vahid-anari/dotmatrix/docs/images/app-clock.png

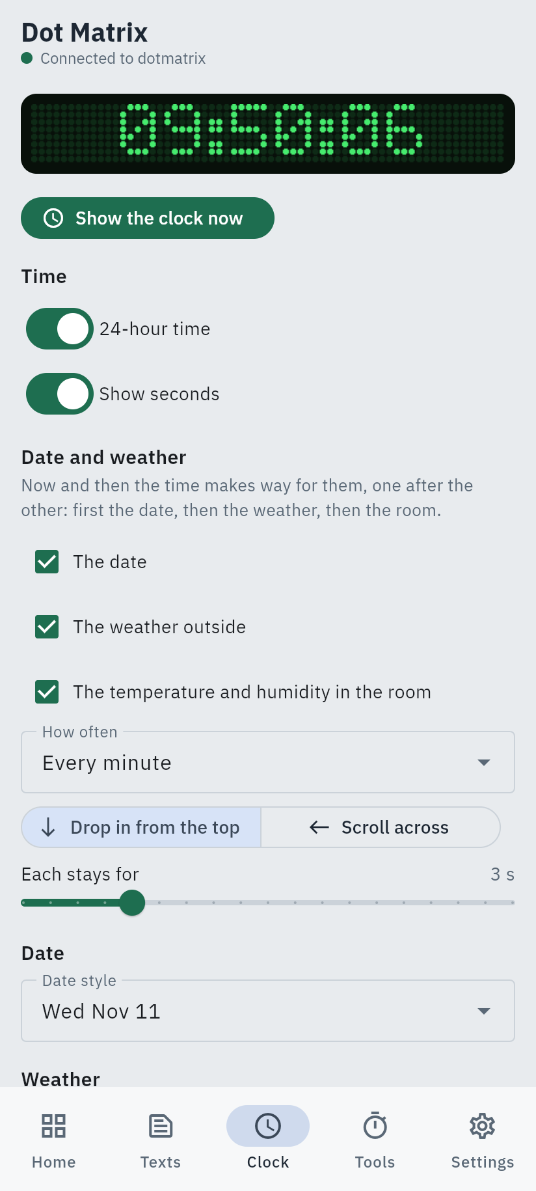
docs/images/app-clock.png
