vahid-anari/dotmatrix/docs/images/app-editor.png

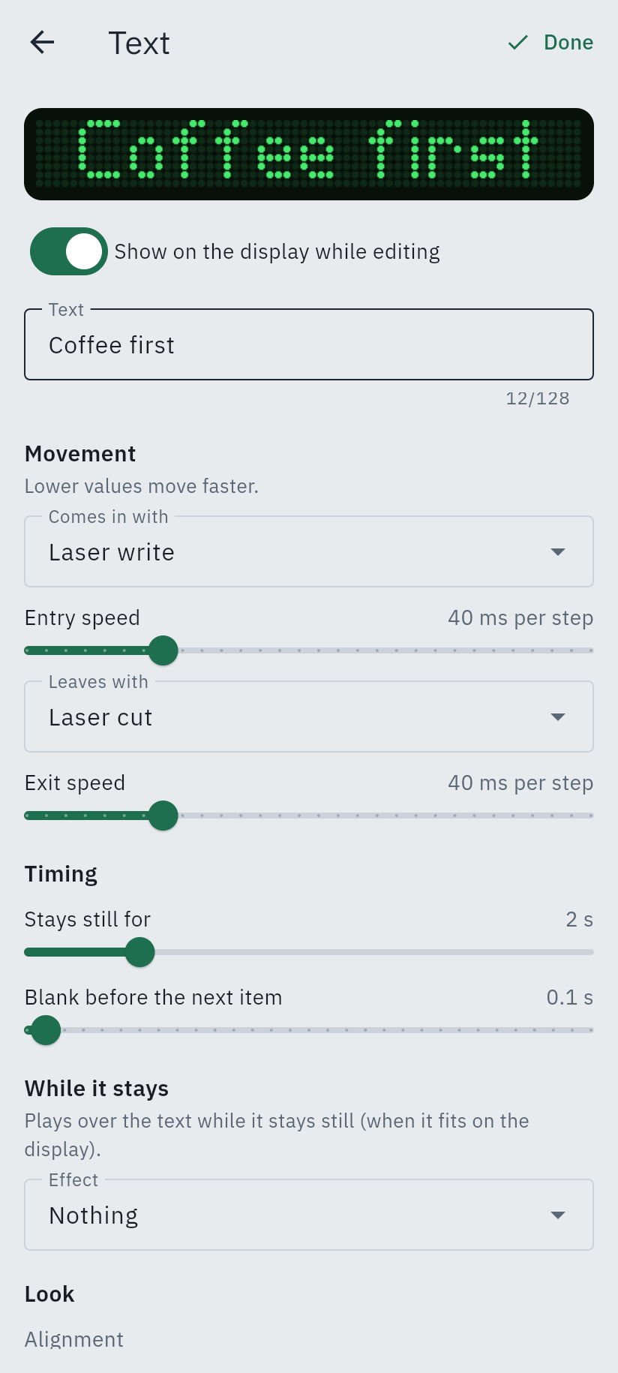
docs/images/app-editor.png
