vahid-anari/dotmatrix/docs/images/app-home.png

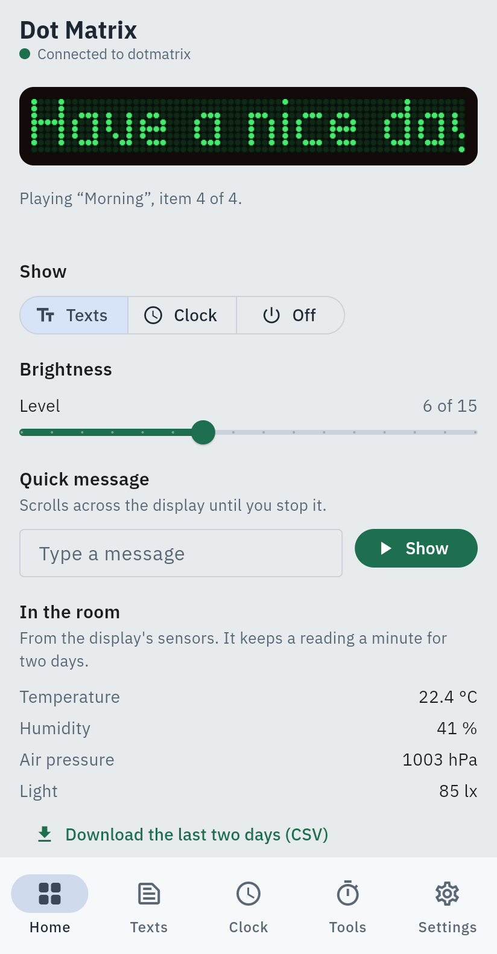
docs/images/app-home.png
