vahid-anari/dotmatrix/docs/images/app-texts.png

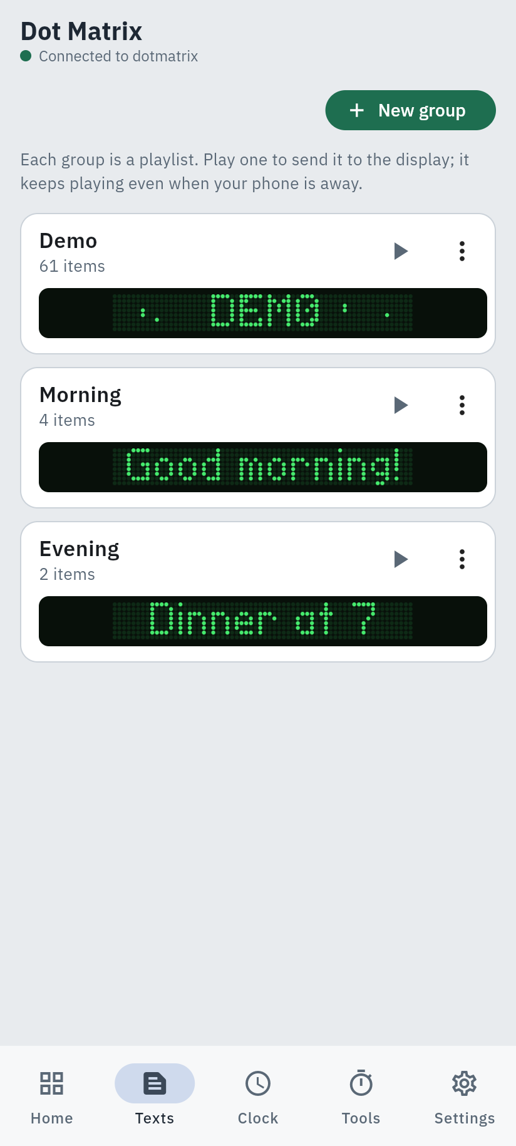
docs/images/app-texts.png
