vahid-anari/dotmatrix/docs/images/app-tools.png

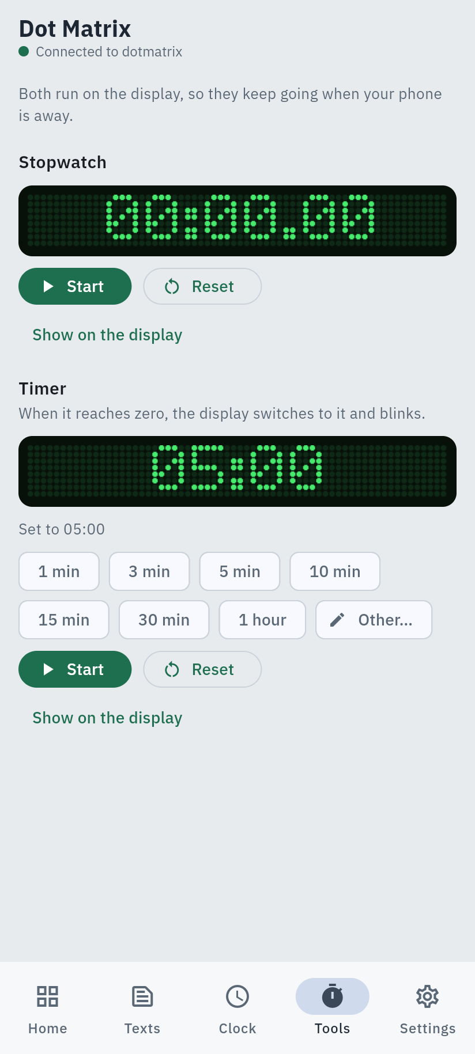
docs/images/app-tools.png
