vahid-anari/dotmatrix/case/stl/assembled-preview.stl

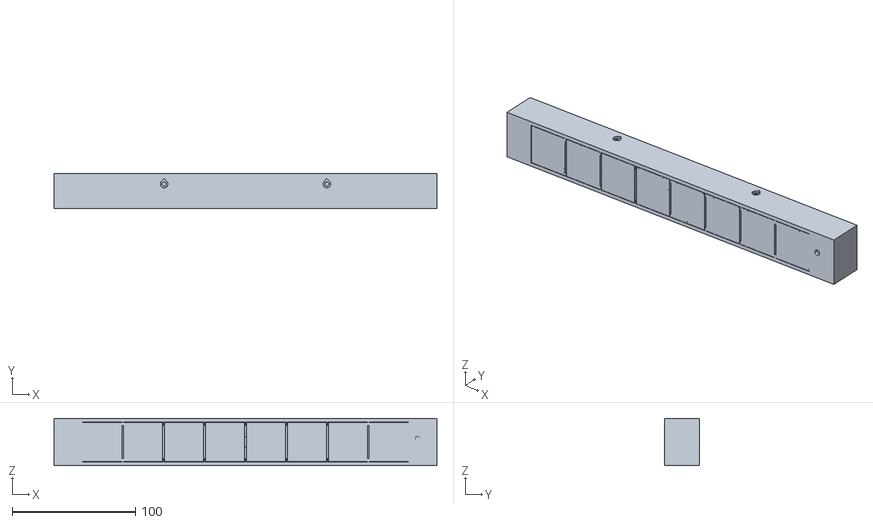
[picture p12: CAD file, 2026-11-11]
case/stl/assembled-preview.stl
310.6 x 28.1 x 38.4
