vahid-anari/dotmatrix/case/stl/foot.stl

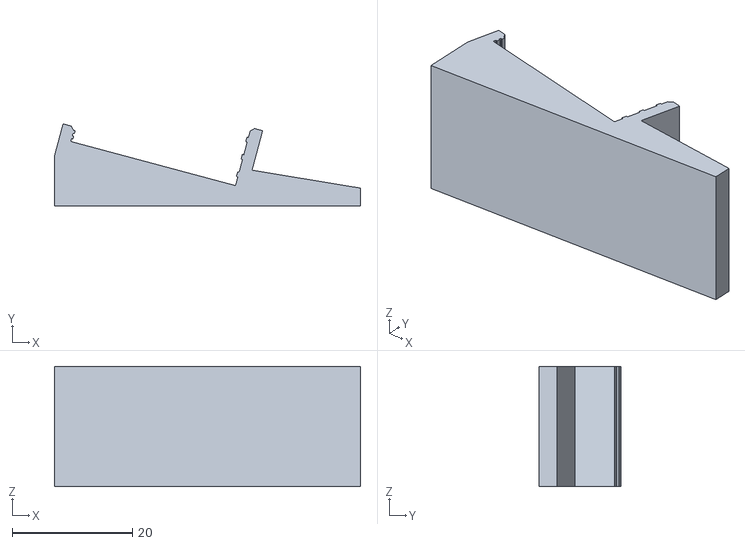
[picture p13: CAD file, 2026-11-12]
case/stl/foot.stl
51.0 x 13.7 x 20.0
