vahid-anari/dotmatrix/case/stl/test_frame.stl

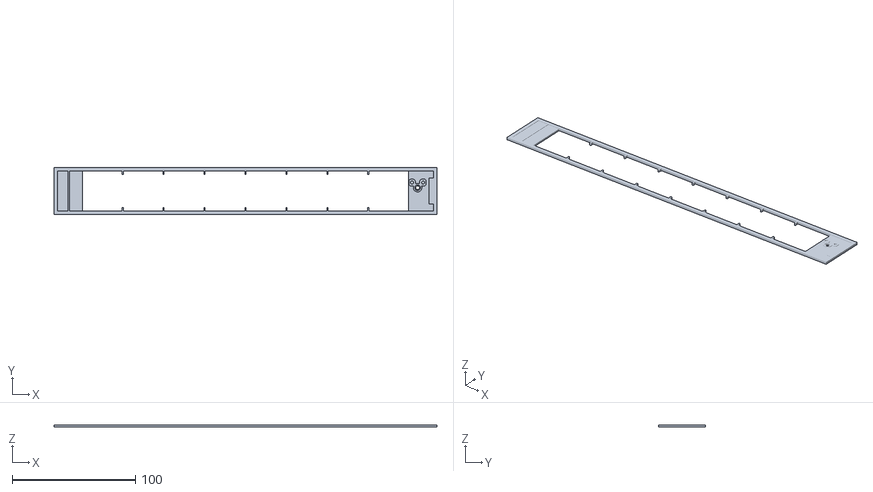
[picture p14: CAD file, 2026-11-11]
case/stl/test_frame.stl
310.6 x 38.4 x 2.00
