vahid-anari/dotmatrix/case/stl/cover.stl

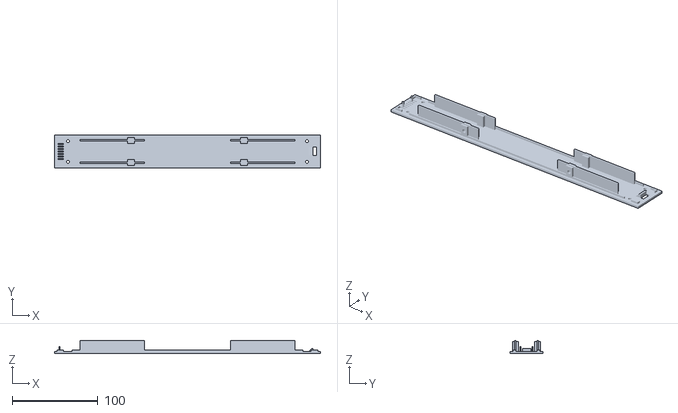
[picture p16: CAD file, 2026-11-11]
case/stl/cover.stl
310.6 x 38.4 x 15.4
