vahid-anari/dotmatrix/case/stl/case.stl

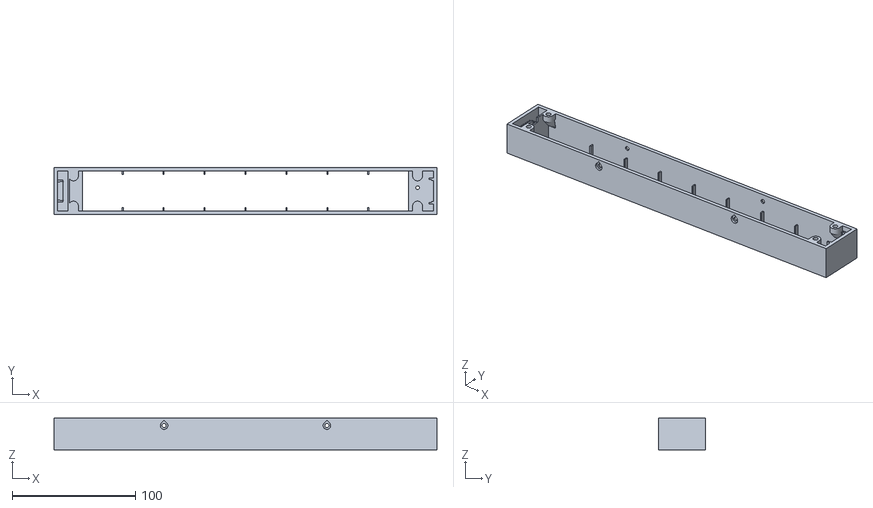
[picture p17: CAD file, 2026-11-11]
case/stl/case.stl
310.6 x 38.4 x 25.7
