vahid-anari/dotmatrix/case/stl/test_cover_l.stl

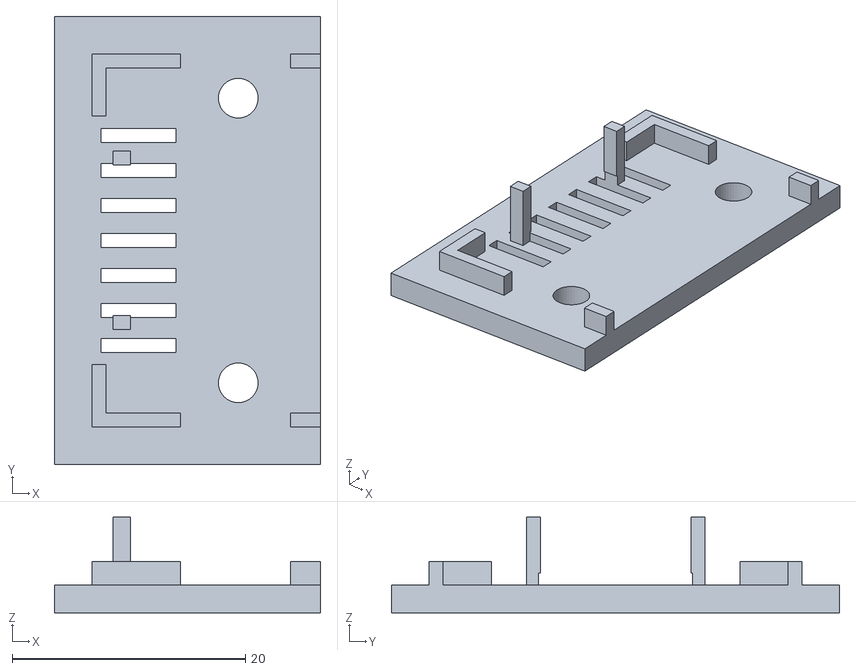
[picture p18: CAD file, 2026-11-11]
case/stl/test_cover_l.stl
22.8 x 38.4 x 8.19
