vahid-anari/dotmatrix/case/stl/test_end_l.stl

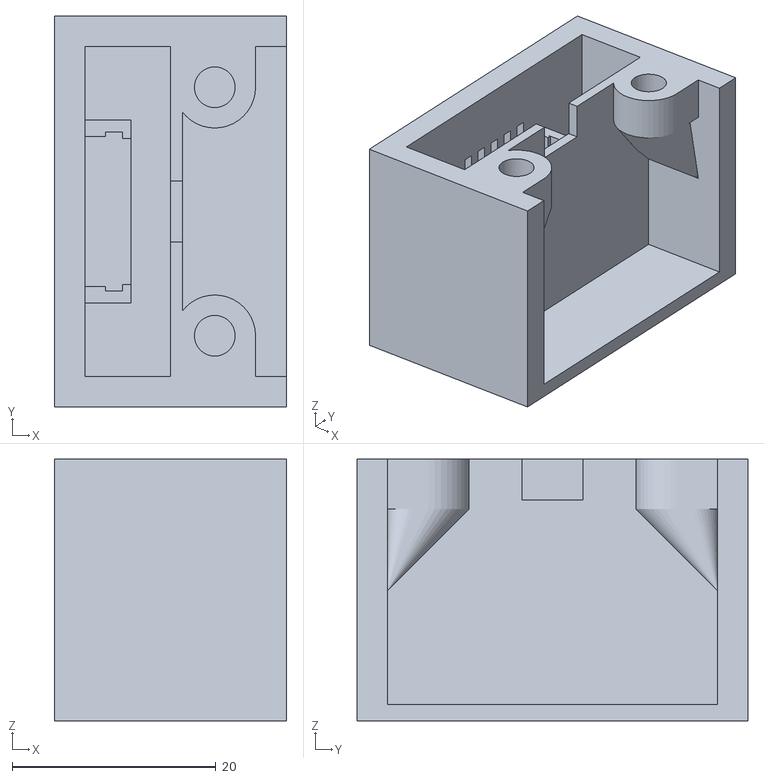
[picture p19: CAD file, 2026-11-11]
case/stl/test_end_l.stl
22.8 x 38.4 x 25.7
