vahid-anari/dotmatrix/case/stl/test_cover.stl

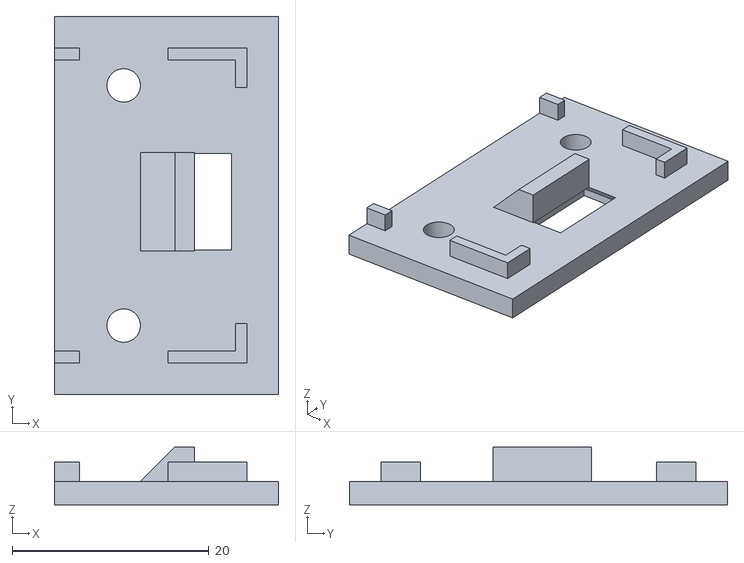
[picture p20: CAD file, 2026-11-11]
case/stl/test_cover.stl
22.8 x 38.4 x 5.89
