vahid-anari/dotmatrix/CHANGELOG.md

# Changelog

Released with tags `vX.Y.Z`; each release carries the signed APK and the firmware,
which the app offers as updates. The version is the app's; the firmware takes the
same number when it changes too.

## 0.8.5 — 2026-11-14

- The Wi-Fi radio stays awake again: with the capacitor, 0.8.3 (awake) had no
  drops, while 0.8.4 (dozing) dropped for a second every few minutes.

## 0.8.4 — 2026-11-14

- Found the cause of the Wi-Fi drops: the display's current spikes reaching the
  ESP32 through the shared 5 V. A 470 µF capacitor across the display's VCC and
  GND fixes it; the wiring guide now asks for one.
- After a drop, each new try starts over with a full search, so the display is
  back seconds after the network is, not minutes.
- The Wi-Fi radio may doze again between the router's signals (saves power;
  keeping it awake didn't help).

## 0.8.3 — 2026-11-13

- Steadier Wi-Fi: the display no longer lets its radio doze between the router's
  signals (the dozing made it miss them and drop, ten times in half an hour).
- After a drop, the display keeps trying for three minutes before it opens its
  setup network; a few seconds' drop used to last 81 s.
- Events show how strong the signal was just before each drop.

## 0.8.2 — 2026-11-13

- History has Events: each time the Wi-Fi was lost (for how long, and why, in plain
  words) and each restart (power on, an update, from the app, or something unusual
  like the watchdog, in orange), with a line that sums up the chosen range. The
  display keeps the last 100; the phone keeps all it fetches.
- The display shows its address only once after it starts, not each time the Wi-Fi
  comes back.

## 0.8.1 — 2026-11-12

- Slider knobs are whole at both ends (at 0 or the top they were cut in half).

## 0.8.0 — 2026-11-12

- Automatic brightness, from the light sensor (Home → Brightness → Automatic): one
  level for a dark room and one for the lights on, set by two sliders, and in between
  by daylight. It changes slowly, so a passing shadow does nothing. While it's on,
  the level slider only shows what the display chose; night dimming still applies.
- History (Home → In the room → History): charts of the room's temperature (with the
  weather outside), humidity, air pressure, light and the display's brightness, over
  a day, a week, a month or everything. Touch a chart to read it. The display keeps
  30 days of quarter-hour averages besides its two days of minutes; the phone keeps
  every quarter hour it has fetched, with no end.

## 0.7.1 — 2026-11-12

- The clock drawn in the app shows the display's time, in the display's time zone,
  even when the phone is somewhere else (it used to show the phone's time).
- The tabs change only from the bar at the bottom: no more swiping between them,
  which a drag on a slider could set off.

## 0.7.0 — 2026-11-12

- One location for the display, chosen by name in Settings → Location: it sets both
  the time zone (any place in the world, with its daylight saving) and where the
  weather comes from. The list of time zones and the place search in Clock are gone.
- In Canada the weather comes from the Canadian weather service's own model (GEM),
  closer to the local forecast.
- When it's raining or snowing now but the sky's code says only clouds, the display
  says Rain or Snow.

## 0.6.0 — 2026-11-10

Sensors, both optional (wiring in docs/HARDWARE.md):

- A BH1750 light sensor (GY-302) and a BME280 for temperature, humidity and air
  pressure (a BMP280 works too, without humidity), on GPIO 1 (SDA) and GPIO 0 (SCL).
  The display finds whichever is fitted.
- Home shows what they read, under "In the room".
- The clock can show the room's temperature and humidity ("In 22°C 41%") after the
  date and the weather (Clock → Date and weather).
- The display keeps a reading a minute for two days, with its brightness, its mode
  and the weather outside; Home → "Download the last two days" gets it as a CSV file
  (or open `http://dotmatrix.local/log.csv`).
- The light sensor sets its own sensitivity, like a camera's exposure: fine steps
  in a dim room, and no ceiling in bright light.

## 0.5.1 — 2026-10-27

The app now looks and behaves like Daftarche and Spoolbook:

- The name stays at the top of every tab, with the connection as a small line under
  it (a tap opens Settings), instead of a heading on each tab.
- Swiping left and right moves between the tabs, and the bottom bar follows.
- Back goes to Home from the other tabs; on Home it asks "Press Back again to exit",
  and a second Back within two seconds leaves the app. An open group or the editor
  closes first.
- Every list ends with room to scroll its last row clear of the bottom bar.
- Messages stay three seconds.
- Settings → About also names the author, the licence (MIT) and where the weather
  comes from (Open-Meteo).

## 0.5.0 — 2026-10-26

- The clock's date and weather come one after the other, at one interval for both;
  each can be switched off.
- They drop in from the top, stay a few seconds (1 to 10 s, adjustable) and go
  back up, with the time sliding away and back; or they scroll across as before.
- The display uses short weather words, so even "-12°C Cloudy" fits.
- Older settings and older apps keep working: the two old intervals are still read
  and reported.
- The night brightness slider no longer calls 0 "Off": it is the dimmest level.

## 0.4.2 — 2026-10-22

- A new app version downloads in the phone's browser, which shows its progress and
  opens the APK when it is done (the in-app page stayed on "Downloading…").

## 0.4.1 — 2026-10-22

- The previews can be drawn in the colour of your display's LEDs: red, green, blue,
  yellow or white (Settings → Appearance).

## 0.4.0 — 2026-10-21

- The weather outside in the clock: with a place chosen (Clock → Weather, by name),
  the display fetches the temperature and the weather from Open-Meteo every 15
  minutes and shows it like the date ("8°C Rain"), in °C or °F. Either can be Never.
- The app's look: Phone (as the phone is set), Light or Dark.

## 0.3.1 — 2026-10-21

- A fourth laser effect: a level beam from the right edge, at the height of the dot,
  draws the text.

## 0.3.0 — 2026-10-21

- Laser effects of our own (write, scan and cut), each coming in and, played
  backwards, going out.
- Effects over a text while it stays: wave, sparkle, pulse, border.
- New animations: a starfield, the Game of Life, fireworks, an equalizer, a snake
  that plays by itself, and a running sprite.
- The editor's LED strip plays the item, animated, the way the display will.
- On older firmware, animations it doesn't have are left out of a playlist, with a
  message.

## 0.2.0 — 2026-10-21

- A stopwatch and a countdown timer on the display (the new Tools tab). They keep
  running with the phone away; the timer comes to the front and blinks at zero.
- Updates: Settings → Updates checks GitHub for new versions, downloads the new app
  or installs new firmware on the display over Wi-Fi; Home shows when one is there.
- A new firmware that fails soon after starting rolls back to the old one.
- The APK is signed with one fixed key, so updates install over the old app.

## 0.1.1 — 2026-10-21

- Making a new group no longer leaves its dialog stuck on the Texts tab.
- The APK is built for 64-bit phones only, a third of the size.

## 0.1.0 — 2026-10-21

- The first version. The display: an ESP32-C3 with eight MAX7219 modules that plays
  a list of texts with entry and exit effects, and animations; the time from the
  internet with daylight saving and night dimming; its own Wi-Fi to set it up; the
  playlist kept through a power cut.
- The app: Home (what the display shows, drawn as LEDs; texts, clock or off;
  brightness; a quick message), Texts (groups as playlists, items to drag into
  order, an editor that can show on the display as you edit), Clock and Settings
  (find the display, its name and time zone, export and import of your texts).
- `tools/dm.py` does the same from a terminal; `tools/fake_device.py` is a pretend
  display for working on the app without hardware.
