vahid-anari/dotmatrix/firmware/src/display/Sprites.cpp

// Sprite animations for the PA_SPRITE effect.
// Data from the MD_Parola "Parola_Sprite_Simple" example (LGPL-2.1, MajicDesigns),
// as collected in Vahid's Sprite library.
#include "Sprites.h"

#include <Arduino.h>

static const uint8_t pacman1_f = 6;
static const uint8_t pacman1_w = 8;
static const uint8_t PROGMEM pacman1[pacman1_f * pacman1_w] =  // gobbling pacman animation
{
  0x00, 0x81, 0xc3, 0xe7, 0xff, 0x7e, 0x7e, 0x3c,
  0x00, 0x42, 0xe7, 0xe7, 0xff, 0xff, 0x7e, 0x3c,
  0x24, 0x66, 0xe7, 0xff, 0xff, 0xff, 0x7e, 0x3c,
  0x3c, 0x7e, 0xff, 0xff, 0xff, 0xff, 0x7e, 0x3c,
  0x24, 0x66, 0xe7, 0xff, 0xff, 0xff, 0x7e, 0x3c,
  0x00, 0x42, 0xe7, 0xe7, 0xff, 0xff, 0x7e, 0x3c,
};

static const uint8_t pacman2_f = 6;
static const uint8_t pacman2_w = 18;
static const uint8_t PROGMEM pacman2[pacman2_f * pacman2_w] =  // ghost pursued by a pacman
{
  0x00, 0x81, 0xc3, 0xe7, 0xff, 0x7e, 0x7e, 0x3c, 0x00, 0x00, 0x00, 0xfe, 0x7b, 0xf3, 0x7f, 0xfb, 0x73, 0xfe,
  0x00, 0x42, 0xe7, 0xe7, 0xff, 0xff, 0x7e, 0x3c, 0x00, 0x00, 0x00, 0xfe, 0x7b, 0xf3, 0x7f, 0xfb, 0x73, 0xfe,
  0x24, 0x66, 0xe7, 0xff, 0xff, 0xff, 0x7e, 0x3c, 0x00, 0x00, 0x00, 0xfe, 0x7b, 0xf3, 0x7f, 0xfb, 0x73, 0xfe,
  0x3c, 0x7e, 0xff, 0xff, 0xff, 0xff, 0x7e, 0x3c, 0x00, 0x00, 0x00, 0xfe, 0x7b, 0xf3, 0x7f, 0xfb, 0x73, 0xfe,
  0x24, 0x66, 0xe7, 0xff, 0xff, 0xff, 0x7e, 0x3c, 0x00, 0x00, 0x00, 0xfe, 0x7b, 0xf3, 0x7f, 0xfb, 0x73, 0xfe,
  0x00, 0x42, 0xe7, 0xe7, 0xff, 0xff, 0x7e, 0x3c, 0x00, 0x00, 0x00, 0xfe, 0x7b, 0xf3, 0x7f, 0xfb, 0x73, 0xfe,
};

static const uint8_t wave_f = 14;
static const uint8_t wave_w = 14;
static const uint8_t PROGMEM wave[wave_f * wave_w] =  // triangular wave / worm
{
  0x08, 0x04, 0x02, 0x01, 0x02, 0x04, 0x08, 0x10, 0x20, 0x40, 0x80, 0x40, 0x20, 0x10,
  0x10, 0x08, 0x04, 0x02, 0x01, 0x02, 0x04, 0x08, 0x10, 0x20, 0x40, 0x80, 0x40, 0x20,
  0x20, 0x10, 0x08, 0x04, 0x02, 0x01, 0x02, 0x04, 0x08, 0x10, 0x20, 0x40, 0x80, 0x40,
  0x40, 0x20, 0x10, 0x08, 0x04, 0x02, 0x01, 0x02, 0x04, 0x08, 0x10, 0x20, 0x40, 0x80,
  0x80, 0x40, 0x20, 0x10, 0x08, 0x04, 0x02, 0x01, 0x02, 0x04, 0x08, 0x10, 0x20, 0x40,
  0x40, 0x80, 0x40, 0x20, 0x10, 0x08, 0x04, 0x02, 0x01, 0x02, 0x04, 0x08, 0x10, 0x20,
  0x20, 0x40, 0x80, 0x40, 0x20, 0x10, 0x08, 0x04, 0x02, 0x01, 0x02, 0x04, 0x08, 0x10,
  0x10, 0x20, 0x40, 0x80, 0x40, 0x20, 0x10, 0x08, 0x04, 0x02, 0x01, 0x02, 0x04, 0x08,
  0x08, 0x10, 0x20, 0x40, 0x80, 0x40, 0x20, 0x10, 0x08, 0x04, 0x02, 0x01, 0x02, 0x04,
  0x04, 0x08, 0x10, 0x20, 0x40, 0x80, 0x40, 0x20, 0x10, 0x08, 0x04, 0x02, 0x01, 0x02,
  0x02, 0x04, 0x08, 0x10, 0x20, 0x40, 0x80, 0x40, 0x20, 0x10, 0x08, 0x04, 0x02, 0x01,
  0x01, 0x02, 0x04, 0x08, 0x10, 0x20, 0x40, 0x80, 0x40, 0x20, 0x10, 0x08, 0x04, 0x02,
  0x02, 0x01, 0x02, 0x04, 0x08, 0x10, 0x20, 0x40, 0x80, 0x40, 0x20, 0x10, 0x08, 0x04,
  0x04, 0x02, 0x01, 0x02, 0x04, 0x08, 0x10, 0x20, 0x40, 0x80, 0x40, 0x20, 0x10, 0x08,
};

static const uint8_t roll1_f = 4;
static const uint8_t roll1_w = 8;
static const uint8_t PROGMEM roll1[roll1_f * roll1_w] =  // rolling square
{
  0xff, 0x8f, 0x8f, 0x8f, 0x81, 0x81, 0x81, 0xff,
  0xff, 0xf1, 0xf1, 0xf1, 0x81, 0x81, 0x81, 0xff,
  0xff, 0x81, 0x81, 0x81, 0xf1, 0xf1, 0xf1, 0xff,
  0xff, 0x81, 0x81, 0x81, 0x8f, 0x8f, 0x8f, 0xff,
};

static const uint8_t roll2_f = 4;
static const uint8_t roll2_w = 8;
static const uint8_t PROGMEM roll2[roll2_f * roll2_w] =  // rolling octagon
{
  0x3c, 0x4e, 0x8f, 0x8f, 0x81, 0x81, 0x42, 0x3c,
  0x3c, 0x72, 0xf1, 0xf1, 0x81, 0x81, 0x42, 0x3c,
  0x3c, 0x42, 0x81, 0x81, 0xf1, 0xf1, 0x72, 0x3c,
  0x3c, 0x42, 0x81, 0x81, 0x8f, 0x8f, 0x4e, 0x3c,
};

static const uint8_t lines_f = 3;
static const uint8_t lines_w = 8;
static const uint8_t PROGMEM lines[lines_f * lines_w] =  // spaced lines
{
  0xff, 0xff, 0xff, 0x00, 0x00, 0xff, 0x00, 0x00,
  0xff, 0xff, 0x00, 0xff, 0x00, 0x00, 0xff, 0x00,
  0xff, 0xff, 0x00, 0x00, 0xff, 0x00, 0x00, 0xff,
};

static const uint8_t arrow1_f = 3;
static const uint8_t arrow1_w = 10;
static const uint8_t PROGMEM arrow1[arrow1_f * arrow1_w] =  // arrow fading to center
{
  0x18, 0x3c, 0x7e, 0xff, 0x7e, 0x00, 0x00, 0x3c, 0x00, 0x00,
  0x18, 0x3c, 0x7e, 0xff, 0x00, 0x7e, 0x00, 0x00, 0x18, 0x00,
  0x18, 0x3c, 0x7e, 0xff, 0x00, 0x00, 0x3c, 0x00, 0x00, 0x18,
};

static const uint8_t arrow2_f = 3;
static const uint8_t arrow2_w = 9;
static const uint8_t PROGMEM arrow2[arrow2_f * arrow2_w] =  // arrow fading to outside
{
  0x18, 0x3c, 0x7e, 0xe7, 0x00, 0x00, 0xc3, 0x00, 0x00,
  0x18, 0x3c, 0x7e, 0xe7, 0xe7, 0x00, 0x00, 0x81, 0x00,
  0x18, 0x3c, 0x7e, 0xe7, 0x00, 0xc3, 0x00, 0x00, 0x81,
};

static const uint8_t sailboat_f = 1;
static const uint8_t sailboat_w = 11;
static const uint8_t PROGMEM sailboat[sailboat_f * sailboat_w] =  // sail boat
{
  0x10, 0x30, 0x58, 0x94, 0x92, 0x9f, 0x92, 0x94, 0x98, 0x50, 0x30,
};

static const uint8_t steamboat_f = 2;
static const uint8_t steamboat_w = 11;
static const uint8_t PROGMEM steamboat[steamboat_f * steamboat_w] =  // steam boat
{
  0x10, 0x30, 0x50, 0x9c, 0x9e, 0x90, 0x91, 0x9c, 0x9d, 0x90, 0x71,
  0x10, 0x30, 0x50, 0x9c, 0x9c, 0x91, 0x90, 0x9d, 0x9e, 0x91, 0x70,
};

static const uint8_t heart_f = 5;
static const uint8_t heart_w = 9;
static const uint8_t PROGMEM heart[heart_f * heart_w] =  // beating heart
{
  0x0e, 0x11, 0x21, 0x42, 0x84, 0x42, 0x21, 0x11, 0x0e,
  0x0e, 0x1f, 0x33, 0x66, 0xcc, 0x66, 0x33, 0x1f, 0x0e,
  0x0e, 0x1f, 0x3f, 0x7e, 0xfc, 0x7e, 0x3f, 0x1f, 0x0e,
  0x0e, 0x1f, 0x33, 0x66, 0xcc, 0x66, 0x33, 0x1f, 0x0e,
  0x0e, 0x11, 0x21, 0x42, 0x84, 0x42, 0x21, 0x11, 0x0e,
};

static const uint8_t invader_f = 2;
static const uint8_t invader_w = 10;
static const uint8_t PROGMEM invader[invader_f * invader_w] =  // space invader
{
  0x0e, 0x98, 0x7d, 0x36, 0x3c, 0x3c, 0x36, 0x7d, 0x98, 0x0e,
  0x70, 0x18, 0x7d, 0xb6, 0x3c, 0x3c, 0xb6, 0x7d, 0x18, 0x70,
};

static const uint8_t rocket_f = 2;
static const uint8_t rocket_w = 11;
static const uint8_t PROGMEM rocket[rocket_f * rocket_w] =  // rocket
{
  0x18, 0x24, 0x42, 0x81, 0x99, 0x18, 0x99, 0x18, 0xa5, 0x5a, 0x81,
  0x18, 0x24, 0x42, 0x81, 0x18, 0x99, 0x18, 0x99, 0x24, 0x42, 0x99,
};

static const uint8_t fireball_f = 2;
static const uint8_t fireball_w = 11;
static const uint8_t PROGMEM fireball[fireball_f * fireball_w] =  // fireball
{
  0x7e, 0xab, 0x54, 0x28, 0x52, 0x24, 0x40, 0x18, 0x04, 0x10, 0x08,
  0x7e, 0xd5, 0x2a, 0x14, 0x24, 0x0a, 0x30, 0x04, 0x28, 0x08, 0x10,
};

static const uint8_t chevron_f = 1;
static const uint8_t chevron_w = 9;
static const uint8_t PROGMEM chevron[chevron_f * chevron_w] =  // chevron
{
  0x18, 0x3c, 0x66, 0xc3, 0x99, 0x3c, 0x66, 0xc3, 0x81,
};

static const uint8_t walker_f = 5;
static const uint8_t walker_w = 7;
static const uint8_t PROGMEM walker[walker_f * walker_w] =  // walking man
{
    0x00, 0x48, 0x77, 0x1f, 0x1c, 0x94, 0x68,
    0x00, 0x90, 0xee, 0x3e, 0x38, 0x28, 0xd0,
    0x00, 0x00, 0xae, 0xfe, 0x38, 0x28, 0x40,
    0x00, 0x00, 0x2e, 0xbe, 0xf8, 0x00, 0x00, 
    0x00, 0x10, 0x6e, 0x3e, 0xb8, 0xe8, 0x00,
};

static const uint8_t wheelforward_f = 6;
static const uint8_t wheelforward_w = 8;
static const uint8_t PROGMEM wheelforward[wheelforward_f * wheelforward_w] =  
{
    0x3c,0x5a,0x99,0xff,0xff,0x99,0x5a,0x3c,
    0x3c,0x7a,0x93,0xdf,0xfb,0xc9,0x5e,0x3c,
    0x3c,0x72,0xb7,0x9f,0xf9,0xed,0x4e,0x3c,
    0x3c,0x66,0xf7,0x9d,0xb9,0xef,0x66,0x3c,
    0x3c,0x66,0xef,0xb9,0x9d,0xf7,0x66,0x3c,
    0x3c,0x4e,0xed,0xf9,0x9f,0xb7,0x72,0x3c,
};

static const uint8_t hourglass_f = 19;
static const uint8_t hourglass_w = 8;
static const uint8_t PROGMEM hourglass[hourglass_f * hourglass_w] = 
{
    0xc3,0xa7,0x9f,0x9f,0xa7,0xc3,0x00,0x00,
    0xc3,0xa7,0x9f,0x9f,0xa7,0xc3,0x00,0x00,
    //start dropping
    0xc3,0xa7,0x9f,0xbd,0xa7,0xc3,0x00,0x00,
    0xc3,0xa7,0x9f,0xdd,0xa7,0xc3,0x00,0x00,
    0xc3,0xa7,0xbd,0xdd,0xa7,0xc3,0x00,0x00,
    0xc3,0xa7,0xdd,0xdd,0xa7,0xc3,0x00,0x00,
    0xc3,0xa5,0xfd,0xdd,0xa7,0xc3,0x00,0x00,
    0xc3,0xe5,0xdd,0xdd,0xa7,0xc3,0x00,0x00,
    0xc3,0xe5,0xdd,0xfd,0xa5,0xc3,0x00,0x00,
    0xc3,0xe5,0xdd,0xdd,0xe5,0xc3,0x00,0x00,
    0xc3,0xe5,0xf9,0xdd,0xe5,0xc3,0x00,0x00,
    0xc3,0xe5,0xf9,0xf9,0xe5,0xc3,0x00,0x00,
    //start flipping
    0x42,0xe7,0xfb,0xfb,0xe7,0x42,0x00,0x00,
    0x24,0x76,0x7a,0x7a,0x76,0x24,0x00,0x00,
    0x14,0x3c,0x7e,0x7e,0x3c,0x14,0x00,0x00,
    0x18,0x3c,0x7e,0x7e,0x3c,0x18,0x00,0x00,
    0x2c,0x3e,0x7f,0x7f,0x3e,0x2c,0x00,0x00,
    0x46,0x6f,0x5f,0x5f,0x6f,0x46,0x00,0x00,
    0xc3,0xa7,0x9f,0x9f,0xa7,0xc3,0x00,0x00,
};

static const Sprite SPRITES[] = {
    {"pacman", pacman1, pacman1_w, pacman1_f},
    {"pacman2", pacman2, pacman2_w, pacman2_f},
    {"wave", wave, wave_w, wave_f},
    {"rolling_square", roll1, roll1_w, roll1_f},
    {"rolling_octagon", roll2, roll2_w, roll2_f},
    {"lines", lines, lines_w, lines_f},
    {"arrow", arrow1, arrow1_w, arrow1_f},
    {"arrow2", arrow2, arrow2_w, arrow2_f},
    {"sailboat", sailboat, sailboat_w, sailboat_f},
    {"steamboat", steamboat, steamboat_w, steamboat_f},
    {"heart", heart, heart_w, heart_f},
    {"invader", invader, invader_w, invader_f},
    {"rocket", rocket, rocket_w, rocket_f},
    {"fireball", fireball, fireball_w, fireball_f},
    {"chevron", chevron, chevron_w, chevron_f},
    {"walker", walker, walker_w, walker_f},
    {"wheel", wheelforward, wheelforward_w, wheelforward_f},
    {"hourglass", hourglass, hourglass_w, hourglass_f},
};

const Sprite* findSprite(const char* id) {
  for (const Sprite& s : SPRITES)
    if (strcmp(s.id, id) == 0) return &s;
  return nullptr;
}

size_t spriteCount() { return sizeof(SPRITES) / sizeof(SPRITES[0]); }
const Sprite& spriteAt(size_t i) { return SPRITES[i]; }
