vahid-anari/dotmatrix/(commit log)

2026-10-21 M2: Android app (Flet) and fake display
    App: Home (now playing drawn as LEDs, mode, brightness, quick message),
    Texts (groups, drag-to-reorder items, editor with live preview on the
    display), Clock (format, date, night dimming), Settings (find the display,
    name, time zone, Wi-Fi, export/import). Reconnects by itself and looks
    for the display again if its address changes.
    tools/fake_device.py speaks protocol v1 so the app can be developed and
    tested without hardware; its effect and animation lists are read from
    the firmware source.
2026-10-21 M3: stopwatch and timer on the display, updates from the app
    Firmware: stopwatch and countdown timer modes that keep running in the
    background; the timer brings itself to the front and blinks when done.
    A new firmware that crashes before it has been online for 30 s (or up
    for 5 min) rolls back to the old one; only one upload at a time. FW_VERSION
    comes from the release tag.
    App 0.2.0: Tools tab; Settings > Updates checks GitHub Releases, downloads
    the new APK, or installs new firmware on the display over Wi-Fi; Home
    shows when an update is available.
    CI checks the app version matches the tag and signs the APK with a
    fixed key from the repo secrets, so updates install over the old app. The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
2026-10-21 M4: lasers, overlays, six new animations, animated preview
    Firmware:
    - Laser effects (our own, drawn by TextFx): laser_write, laser_scan and
    laser_cut, each as entry and, played backwards, as exit effect.
    - Overlays during a text's pause: wave, sparkle, pulse, border.
    - Animations: starfield, Game of Life, fireworks, equalizer, a snake that
    plays by itself, and a running sprite (params.sprite).
    - A text with a laser or an overlay plays in phases (Parola or TextFx in,
    our frames with the overlay, Parola or TextFx out). drawText now puts text
    exactly where Parola does, so the hand-overs don't show.
    - "None" as an entry effect shows the text instead of skipping the item.
    - hello lists t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
    [Display.cpp, Display.h, DisplayText.cpp, Effects.cpp, Effects.h]
2026-10-21 Laser beam: a level beam from the right edge draws the text (0.3.1)
    Like laser write, but the beam comes from the right-hand edge, always at
    the height of the dot it is drawing, so it is a horizontal line. Works as
    an entry effect and, erasing in the same order, as an exit effect. Added at
    the end of the effects table; the app's preview plays it too.
2026-10-21 CI: release by itself when a push raises the version
    A push to main whose version (app/pyproject.toml) has no vX.Y.Z tag yet is
    built, tested and released, and the release creates the tag. Pushes that
    keep the version only build and test. Pushing a tag by hand still works.
    One run at a time per branch, so two quick pushes can't both release.
    This releases 0.3.1 (the laser beam).
2026-10-21 Weather outside in the clock; light, dark or phone theme (0.4.0)
    Firmware: with a place set, the display reads the current temperature and
    weather from Open-Meteo every 15 minutes, in a background task so a slow
    answer never stalls the display. The clock shows it like the date
    ("8°C Rain") every clock.weather_every seconds; either can be Never.
    New settings: weather.place/lat/lon/units. The state carries the reading.
    App: the Clock tab gets a Weather section: choose the place by name
    (Open-Meteo place search), °C or °F, how often. Settings → Appearance:
    Phone (as the phone is set), Light or Dark.
2026-10-21 Add a Buy Me a Coffee button and a Support section
2026-10-21 Docs: wiring diagram and hardware page
    docs/wiring.svg shows the five wires from the ESP32-C3 Super Mini to the
    chained MAX7219 boards, powered from the board's 5V pin. docs/HARDWARE.md
    has the parts, the pin table, and tips on power, 3.3 V logic, pin labels
    and orientation. The README shows the diagram.
2026-10-22 Desk case: OpenSCAD model, STL files and previews
    A front shell (prints face down, diagonally on a 256 mm bed), a back
    cover that holds the ESP32 with its USB-C at the back, and two feet that
    lean it back 10 degrees. Drawn from typical FC-16 sizes; all of them are
    settings at the top of the file. render.sh exports the STLs and pictures.
    [back.stl, dotmatrix_case.scad, foot.stl, preview_text.scad, shell.stl]
2026-10-22 Case: remove two old preview pictures
2026-10-22 Case: an assembled preview STL, to look at in 3D without OpenSCAD
    [assembled-preview.stl]
2026-10-22 App 0.4.1: choose the LED colour of the previews
    Settings > Appearance has five swatches (red, green, blue, yellow, white),
    like the matrices you can buy, so the app shows the colour your display
    really has. Every preview follows it.
2026-10-26 0.5.0: date and weather one after the other, dropping in from the top
    The clock now has one interval for its extras: the date, then the weather
    (each can be switched off). They drop in from the top, stay a few seconds
    (adjustable) and go back up, with the time sliding away and back; or they
    scroll across as before. The display uses short weather words so even
    "-12°C Cloudy" fits. Older settings and older apps keep working: the two
    old intervals are still read and reported.
    The night brightness slider no longer calls 0 "Off": it's the dimmest level.
2026-11-11 Firmware: read the optional BH1750 and BME280 sensors over I2C
    The sensors sit on SDA GPIO 1 / SCL GPIO 0. Each is found at start (and
    looked for again every 30 s while missing), read every 1-2 s, logged every
    10 s, and reported in the state message as "sensors". The BME280 is driven
    directly (Bosch compensation formulas), so no new library.
    [Sensors.cpp, Sensors.h, config.h]
2026-11-11 0.6.0: room readings on Home and the clock, a two-day sensor log
    - The BH1750 runs in high-resolution mode 2 and sets its measuring time
    itself: 254 while dim (0.11 lx steps), 31 near the top (up to ~60000 lx).
    - The display keeps a row a minute for two days (sensors, brightness, mode,
    outside temperature), saved to flash every ten minutes, served as
    /log.csv in chunks.
    - The clock can show the room's temperature and humidity after the date and
    the weather (clock.show_indoor, on by default).
    - The app shows the readings under Home → In the room, with a link to the
    CSV, and the new clock option when a temperature sensor answers.
    - The fake device reports sensors and serves a short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
    [SensorLog.cpp, SensorLog.h, Sensors.cpp, Sensors.h]
2026-11-11 Docs and case: the sensors, app screenshots, the new shelf case
    - case/: the new one-piece case (body + back cover, upright on a shelf,
    ESP32 held by printed lips and a wall on the cover, 10 M3x6 screws and
    8 heat-set inserts), its STLs and test pieces, new pictures, and the
    partbin board models as a submodule. The old desk case is gone.
    - docs/wiring-sensors.svg and the sensors in HARDWARE.md, DESIGN.md and
    the firmware README.
    - docs/images/: app screenshots (Home, Texts, editor, Clock, Tools),
    shown in the README and the app README.
    - README: the sensors, the room on Home and in the clock, the CSV log,
    clone with --recursive, what's planned next.
    - The fake device has a weathe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
    [assembled-preview.stl, back.stl, case.stl, cover.stl, dotmatrix_case.scad, foot.stl, preview_text.scad, shell.stl]
2026-11-12 Case: two clip-on feet that lean it back 15 degrees
    dotmatrix_foot.scad: a U that takes the case's bottom (0.15 clearance a side,
    ribs gripping 0.1), a 2.5 mm front lip below the LEDs and a 10 mm back lip on
    the cover, a flat base reaching 20 mm behind. Printed on its side. Tried at
    10 and 15 degrees; 15 chosen.
    [dotmatrix_case.scad, dotmatrix_foot.scad, foot.stl]
2026-11-12 0.7.0: one location for time zone and weather; GEM model in Canada
    - Settings -> Location: one place search sets the weather's place, its
    country and the time zone. The zone's IANA name is turned into the POSIX
    rule the display needs from the tzdata package (the rule ends each zone's
    file), so any place works. The time zone list and Clock's place search
    are gone; Clock links to Settings.
    - Firmware: weather.country; for "CA" Open-Meteo is asked for the GEM model
    (models=gem_seamless). Precipitation is read too: a clouds-only code with
    0.1 mm or more becomes Rain (Snow at 0.5 C and below).
    - Tests for the zone rule, the place fields and the country setting.
2026-11-12 0.7.1: the app's clock follows the display's time; no swiping between tabs
    - Device.local_time(): the display's reported local time moved on by what
    has passed since; the Home and Clock previews draw it, so a display in
    another time zone shows its own time in the app.
    - The PageView is gone: one tab at a time, changed only from the bar (a drag
    on a slider could change the tab).
2026-11-12 0.8.0: automatic brightness, and History charts
    Firmware
    - auto_brightness {enabled, dark, bright}: the light, smoothed, sets the
    level on a log scale from dark (0 lx) to bright (40 lx and up); a new level
    must hold 3 s, then it moves a step a second; night dimming caps it. State
    reports auto_brightness.
    - SensorLog keeps 30 days of quarter-hour averages in a flash ring
    (/sensorlog15.bin) besides the two days of minutes; the minutes are saved
    in place (no copy beside them: flash is short). /api/log?res=1|15&since=
    serves either in Unix time; each download has its own cursor.
    App
    - Home: an Automatic switch; while on, the level slider only shows the
    display's choice and two sli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
    [SensorLog.cpp, SensorLog.h]
2026-11-12 0.8.1: slider knobs whole at both ends
    LabeledSlider had no padding, so at 0 or the top the knob's outer half was
    cut off; 10 px on each side leaves room for it.
2026-11-13 0.8.3: Wi-Fi stays awake, patient reconnect, signal strength in events
2026-11-14 0.8.4: capacitor at the display fixes the Wi-Fi drops; full search on reconnect
    [config.h]
